GustavoFWolf/TecladoEletronicoInterativo/README.md

# TecladoEletronicoInterativo
O projeto tem como motivação facilitar a aprendizagem de novas músicas em um simples piano de uma oitava, 
consistindo de um esquema de leds interativos que auxiliam as notas que devem ser tocadas no momento correto.
O trabalho foi realizado através de um ESP32 como microcontrolador, que em conjunto com o MAX98357 um aplificador de audio
e seguindo o protocolo I2S permite gerar som de uma maneira mais fiel.
Foi utilizado conhecimentos de logica de programação em C/C++, FreeRTOS e até mesmo a criação de um site feito em html que permite o usuário ter um feedback do seu progresso.

link do video no youtube do projeto: https://youtu.be/L0N_faVM1Qg
